alpine183/SBC8080A/SBC8080A一枚版s2.jpg

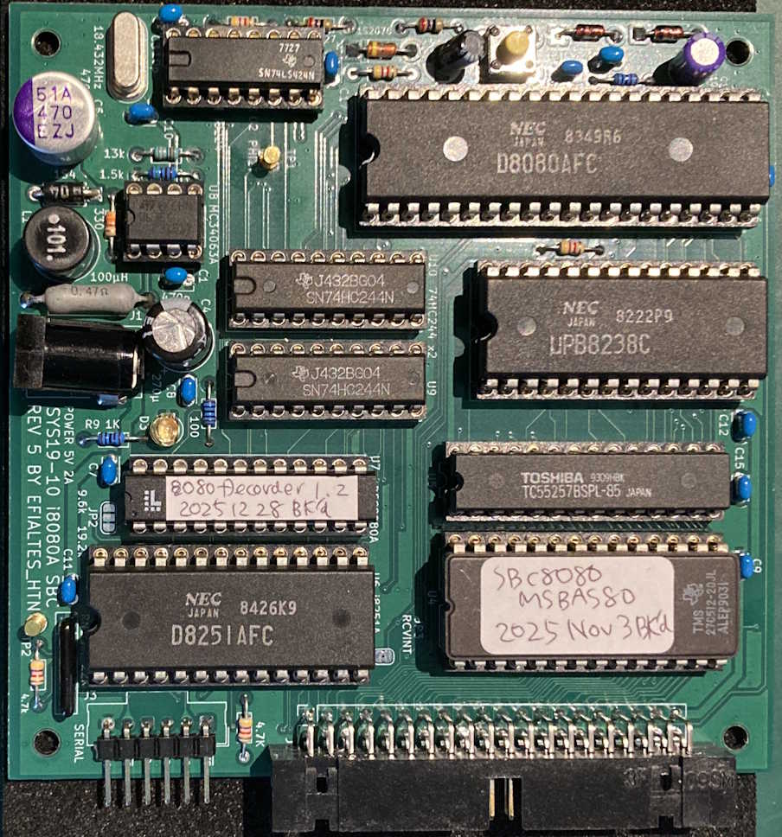
SBC8080A一枚版s2.jpg
