alpine183/SBC8080A/README.md

SBC8080A based on vintage chips-san 2 board SBC design.
Schematics, PLD files and garber files are included.

Same softwares located at https://vintagechips.wordpress.com/2018/06/24/sbc8080-cpu%e3%83%ab%e3%83%bc%e3%82%ba%e3%82%ad%e3%83%83%e3%83%88/ can be applied.

Have fun.
