alpine183/SBC8080A/SBC8080A-SCHEMA_rev13.pdf

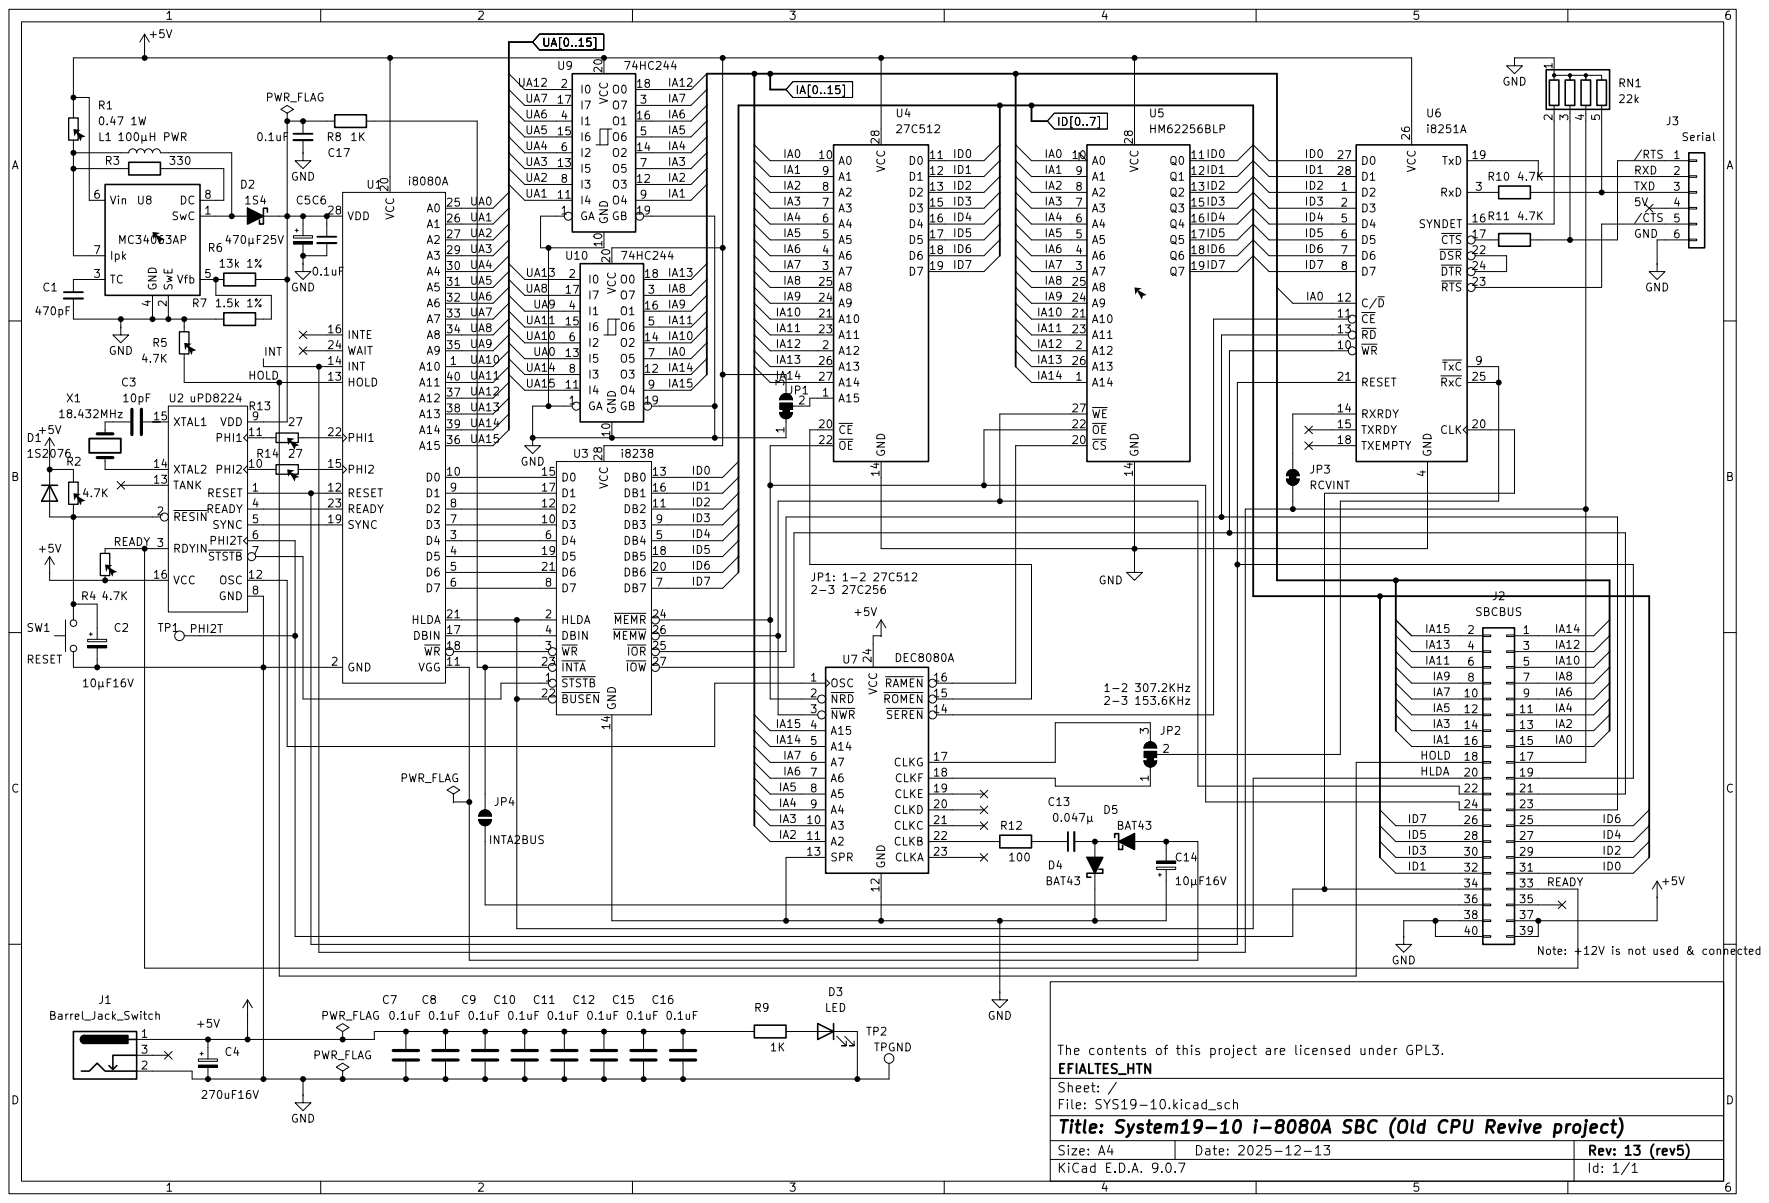
[picture p8: page 1]
